microrack/qfilter/(commit log)

2020-11-11 Replase operational amplifier 4 chanel (LM324) to 2 chanel (LM2904)
    [qfilter.sch]
2020-11-15 Edit schematics with new component SlideSwitch, Replase power conectors, Place power conусещкы for a pcb.
    [qfilter.kicad_pcb, qfilter.sch]
2020-11-30 fix schematic, place components
    [qfilter.kicad_pcb, qfilter.sch]
2020-11-30 Make PCB.
    [qfilter.kicad_pcb, qfilter.sch]
2020-12-01 change conection transistor Q1
    [qfilter.kicad_pcb, qfilter.sch]
2020-12-03 Reconect Q1
    [qfilter.kicad_pcb, qfilter.sch]
2020-12-15 add logo
    [qfilter.kicad_pcb]
